sunliguo2020/48v-ev-monitor-board/程序运行顺序.md

Arduino（ESP8266/ESP32 Arduino框架）程序的执行顺序和普通 C 程序不一样，它不是从文件第一行开始执行，而是由框架调用。

你的 `wireless_meter.ino` 执行流程如下：

```
上电 / 复位
       │
       ▼
Arduino核心初始化
       │
       ▼
setup()
       │
       ▼
loop()
       │
       └────不断循环执行
```

---

## 1. 上电后首先执行 setup()

你的程序第一步进入：

```cpp
void setup()
{
  Serial.begin(115200);

  BLINKER_DEBUG.stream(Serial);
  BLINKER_DEBUG.debugAll();

  ...
}
```

也就是说：

### 第一步：

打开串口：

```cpp
Serial.begin(115200);
```

串口输出：

```
115200波特率
```

---

## 2. 读取 EEPROM 中的 WiFi 配置

接下来：

```cpp
if (!loadWiFiConfig())
{
  Serial.println("没有存储的 WiFi 配置，进入配网模式...");
  startConfigPortal();
}
```

执行：

```
loadWiFiConfig()
```

流程：

```
EEPROM.begin()
       |
       |
读取地址3000
       |
       |
判断是否等于0xA5
       |
       |
读取:
SSID
密码
Blinker Auth
```

如果没有配置：

进入：

```cpp
startConfigPortal();
```

启动AP：

```
EVMeter_Config
```

等待手机连接配网。

---

## 3. 连接 WiFi

如果 EEPROM 有数据：

执行：

```cpp
connectWiFi()
```

里面：

```cpp
WiFi.begin(ssid, pswd);
```

等待：

```
WiFi连接成功
```

例如：

```
Connected, IP:192.168.1.xxx
```

---

## 4. 初始化 Blinker

接下来：

```cpp
Blinker.begin(auth, ssid, pswd);
```

连接云端。

然后绑定各种回调：

### 心跳：

```cpp
Blinker.attachHeartbeat(heartbeat);
```

以后每隔一定时间执行：

```
heartbeat()
```

---

### 数据存储：

```cpp
Blinker.attachDataStorage(dataStorage);
```

执行：

```
dataStorage()
```

上传历史数据。

---

### 小爱控制：

```cpp
BlinkerMIOT.attachPowerState(miotPowerState);
```

语音控制进入：

```
miotPowerState()
```

---

## 5. GPIO初始化

继续：

```cpp
pinMode(D6, OUTPUT);
digitalWrite(D6, HIGH);
```

这里：

D6 是你的输出控制 MOS 管。

上电：

```
D6=高电平
```

打开输出。

蜂鸣器：

```cpp
pinMode(D5, OUTPUT);
digitalWrite(D5, LOW);
```

关闭蜂鸣器。

---

## 6. 绑定APP按键

执行：

```cpp
Button2.attach(button2_callback);
Button9.attach(button9_callback);
Button7.attach(button7_callback);
Button8.attach(button8_callback);
Button6.attach(button6_callback);
```

以后：

APP按键2：

```
button2_callback()
```

APP屏幕开关：

```
button9_callback()
```

APP清除：

```
button7_callback()
```

APP模式：

```
button8_callback()
```

APP重启：

```
button6_callback()
```

---

## 7. 初始化DHT11

这里：

```cpp
dht.begin();
```

启动：

```
温湿度传感器
```

---

## 8. 初始化NTP时间

```cpp
timeClient.begin();
```

启动：

```
阿里云时间服务器
```

---

## 9. 初始化 INA226

这里是你的关键：

```cpp
ina226Ready = initINA226();
```

进入：

```
initINA226()
```

里面：

### I2C启动：

```cpp
Wire.begin();
```

### 检查 INA226 地址：

```cpp
Wire.beginTransmission(0x44);
```

你的INA226地址：

```
0x44
```

读取配置寄存器：

```
CONFIG
```

然后：

```cpp
ina.begin(0x44);
```

配置：

```cpp
ina.configure(
INA226_AVERAGES_128,
INA226_BUS_CONV_TIME_1100US,
INA226_SHUNT_CONV_TIME_1100US,
INA226_MODE_SHUNT_BUS_CONT
);
```

也就是：

```
平均128次
母线转换1.1ms
分流转换1.1ms
电压+电流连续模式
```

校准：

```cpp
ina.calibrate(0.002,40);
```

表示：

```
分流电阻 0.002Ω
最大电流40A
```

---

## 10. 初始化OLED

执行：

```cpp
u8g2.begin();
```

启动：

```
SSD1306 OLED
```

然后：

```cpp
displaygif();
```

显示动画。

再：

```cpp
connectHell();
```

显示：

```
尊贵的车主！
Hell!
戴头盔注意安全！
```

setup结束。

---

# 11. 进入 loop()

setup执行一次后：

进入：

```cpp
void loop()
{
```

然后无限循环。

你的loop主要流程：

```
loop()
 |
 |
 +-- Blinker.run()
 |
 +-- 更新时间
 |
 +-- Runtime()
 |
 +-- 每200ms采集一次
 |       |
 |       +-- INA226读取
 |       |
 |       +-- 电压
 |       +-- 电流
 |       +-- 功率
 |       +-- 电量
 |       +-- 里程
 |
 +-- DHT11读取
 |
 +-- 自动模式保护
 |
 +-- 手动模式控制
 |
 +-- 超压保护
 |
 +-- 过温保护
 |
 +-- 过流保护
 |
 +-- OLED显示
```

---

# 你的实际运行主线图

```
上电
 |
 ▼
setup()
 |
 +-- EEPROM读取WiFi
 |
 +-- WiFi连接
 |
 +-- Blinker连接
 |
 +-- GPIO初始化
 |
 +-- DHT11初始化
 |
 +-- NTP初始化
 |
 +-- INA226初始化
 |
 +-- OLED初始化
 |
 +-- GIF
 |
 +-- 欢迎画面
 |
 ▼
loop()
 |
 +-- 采集电压
 |
 +-- 采集电流
 |
 +-- 计算电量
 |
 +-- 判断保护
 |
 +-- 控制D6 MOS输出
 |
 +-- 更新OLED
 |
 +-- 上传APP
 |
 └────重复
```

---

针对你这个 **48V新能源电动车监测板**，真正核心运行位置是：

1. **采集数据**

```cpp
BusVoltage = ina.readBusVoltage()*Vscale;
ShuntCurrent = ina.readShuntCurrent();
```

2. **保护判断**

```cpp
if(BusVoltage < 42.9)
```

```cpp
if(temp_read >55)
```

```cpp
if(ShuntCurrent < -25)
```

3. **控制输出**

```cpp
digitalWrite(D6,HIGH/LOW);
```

4. **显示**

```cpp
displayALL();
```

这四部分构成你的主程序。你这个程序结构已经比较完整，接近一个成品电动车BMS辅助监测系统。
