sunliguo2020/48v-ev-monitor-board/images/PCB_PCB1_2026-07-01.png

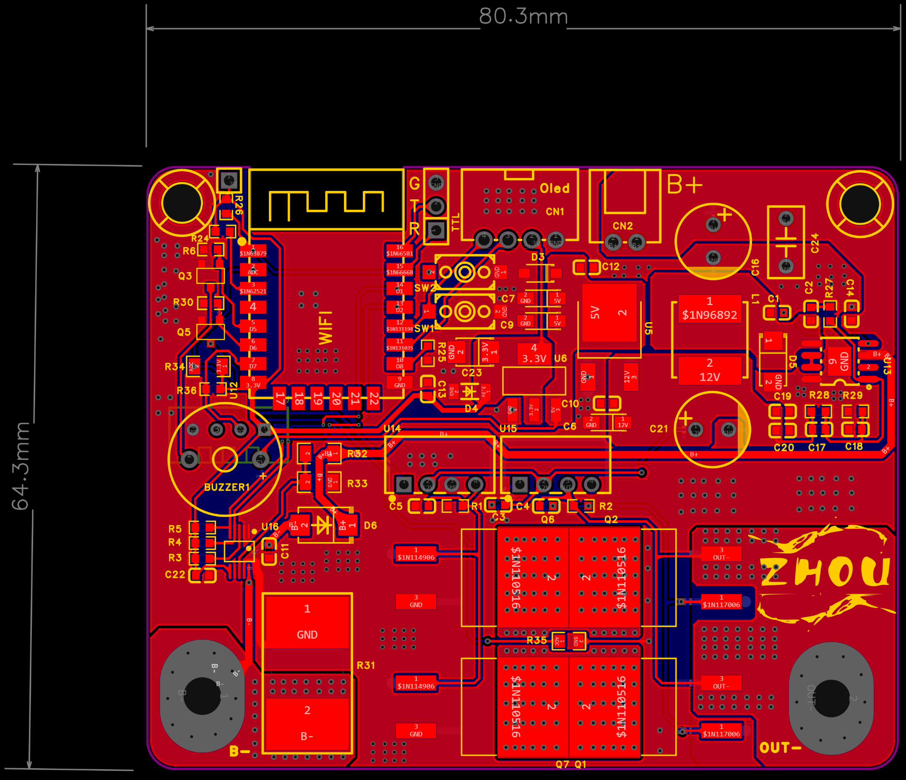
images/PCB_PCB1_2026-07-01.png
