sunliguo2020/48v-ev-monitor-board/CHANGELOG.md

# CHANGELOG

## [2026-07-16]

### 重构
- WiFi 配网功能单独抽离为独立模块 (`WiFi_Config.cpp/.h`)

## [2026-07-13]

### 重构
- 将开机显示 GIF 图片的部分分离出来 (`DisplayGif.cpp/.h`, `Gif.cpp/.h`)

## [2026-07-10]

### 文档
- 添加程序运行逻辑说明文档 (`程序运行顺序.md`)
- 部分函数增加注释

## [2026-07-08]

### 修复
- 修复 INA226 不能正确读取电压的问题
- 寻找 INA226 正确的 I2C 地址

## [2026-07-07]

### 新功能
- 配网界面适配手机浏览器
- 增加 `.gitignore` 文件
- 旋转图片显示

### 修复
- 修复 WiFi 配置持久化问题：移动 EEPROM 区域以避免与 Blinker 重叠；增加安全的 EEPROM 读写和调试日志

## [2026-07-01]

### 文档
- 更新 README 文件
- 添加网表文件以及原理图 (PCB 文档)

### 其他
- 删除重复的文件

## [2026-06-21]

### 文档
- 更新 `wireless_meter.ino` 开头注释
- 更新 README.md：基于 `wireless_meter.ino` 功能添加详细项目文档

### 代码优化
- 格式化代码：改进 `wireless_meter.ino` 的代码风格和一致性

## [2023-04-16]

### 修复
- 修改导致编译失败的程序错误

### 其他
- 使用 INA226 库

## [2023-04-11]

### 修复
- 修复低压报警，手动打开蜂鸣无法关断问题
- 修复低压报警手动打开、报警页面卡滞问题

### 已知问题
- 电池彻底亏电，控制板无法启动导致无法充电问题。需要复刻的朋友需要自己设计增加二极管将 GND 与 OUT- 隔离后与 DCDC 连接，即使电池彻底亏电，充电器也可以启动系统。
