sunliguo2020/48v-ev-monitor-board/pcb/SCH_Schematic1_2026-06-07.pdf

# GNDB-

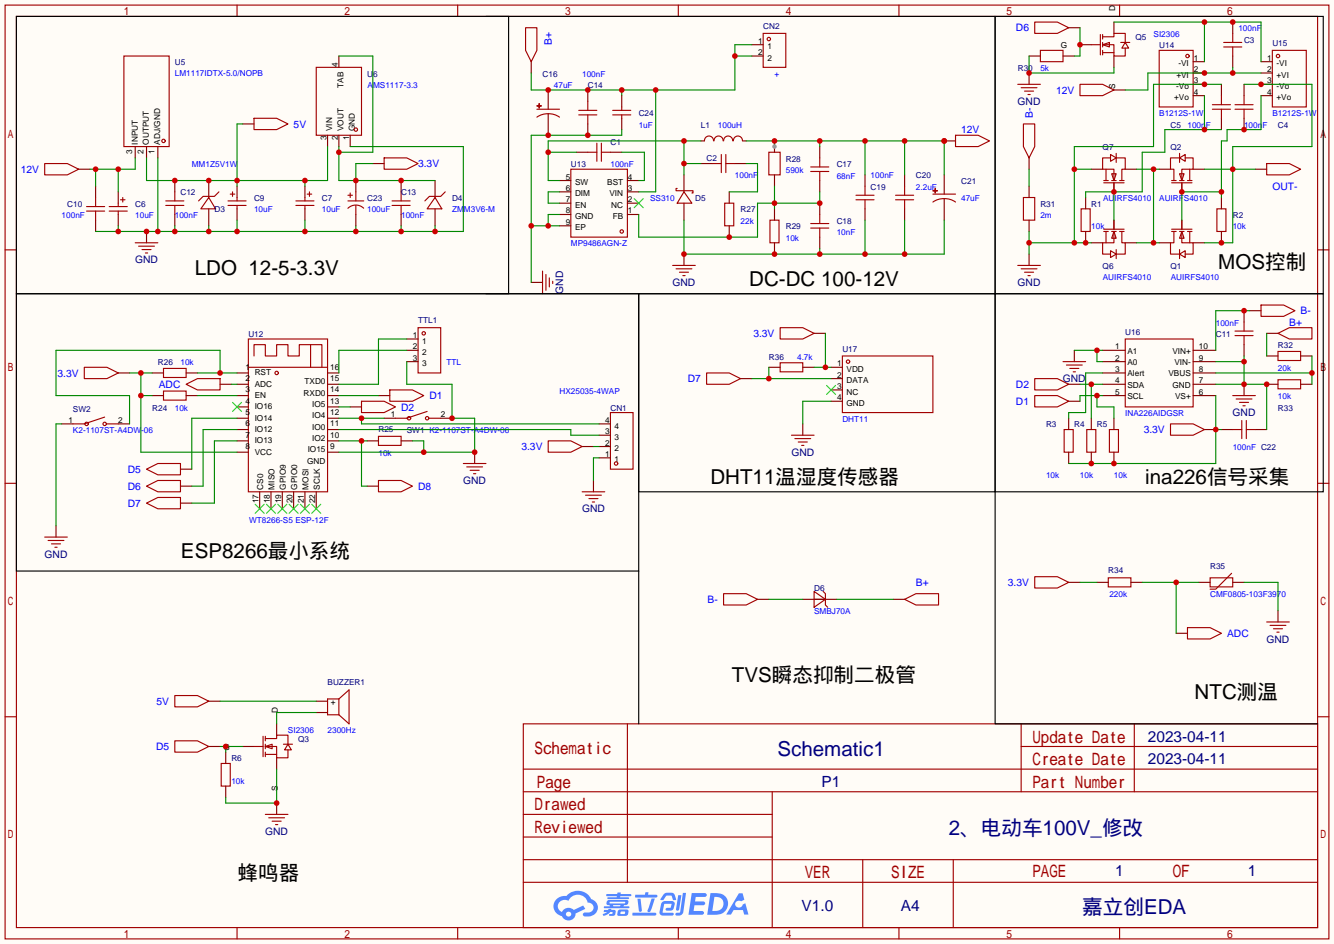
[picture p3: page 1]
