sunliguo2020/48v-ev-monitor-board/pcb/SCH_Schematic1_2026-06-21.pdf

# GNDB-

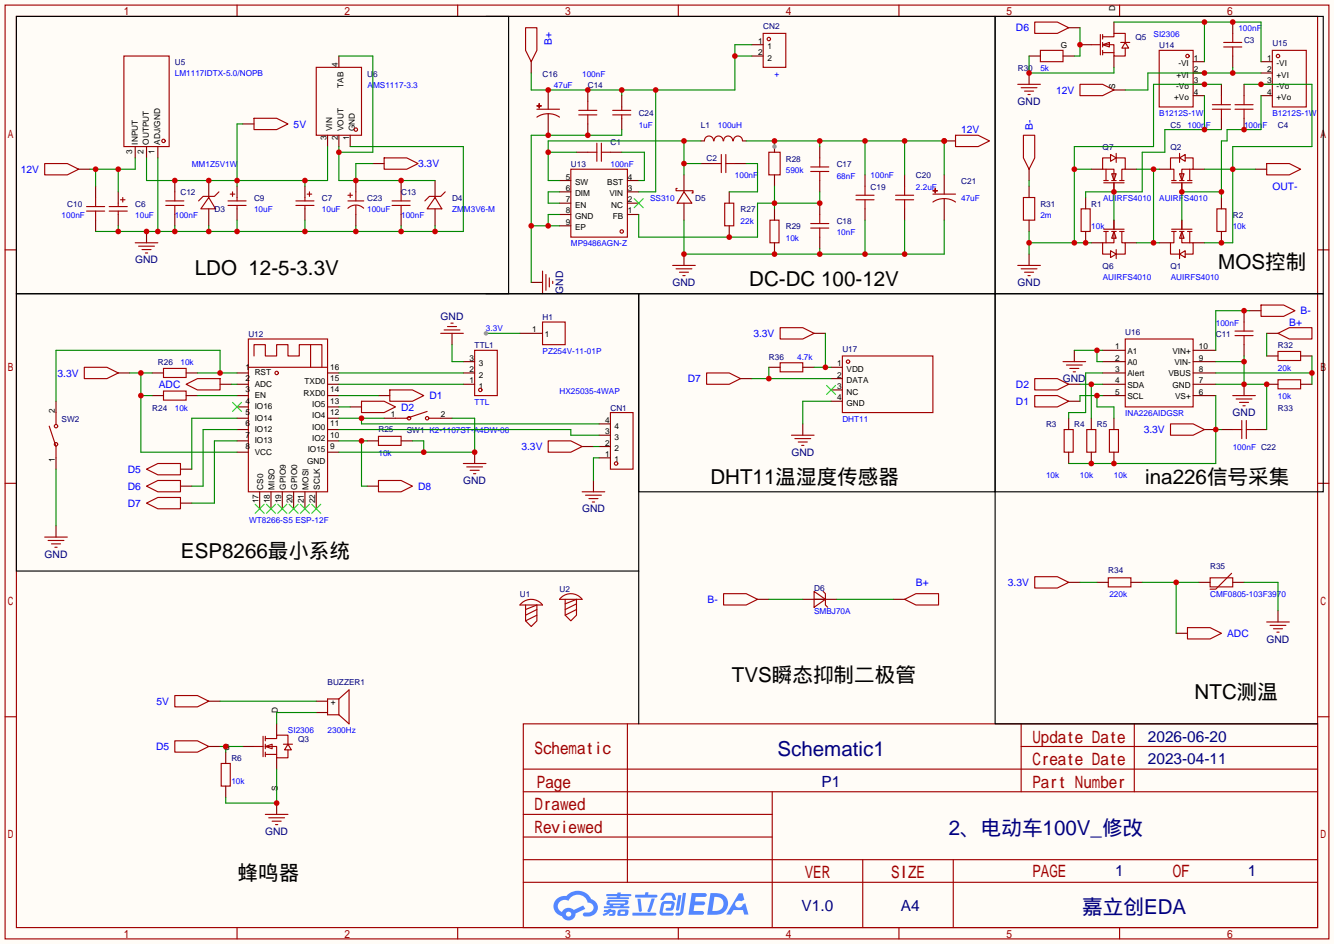
[picture p4: page 1]
