sunliguo2020/48v-ev-monitor-board/wireless_meter/Gif.cpp

#include <Arduino.h>
#include "Gif.h"
const int gif_length = GIF_LENGTH;


const uint8_t gif[GIF_LENGTH][512] PROGMEM ={
0x00, 0x00, 0x00, 0x00, 0x00, 0x00, 0x00, 0x00, 0x00, 0x00, 0x00, 0x00, 0x00, 0x00, 0x00, 0x00, 
0x00, 0x00, 0x00, 0x00, 0x00, 0x00, 0x00, 0x00, 0x00, 0x00, 0x00, 0x00, 0x98, 0x00, 0x00, 0x00, 
0x00, 0x00, 0x00, 0x00, 0x0c, 0x01, 0x00, 0x00, 0x00, 0x00, 0x00, 0x00, 0x61, 0x02, 0x00, 0x00, 
0x00, 0x00, 0x00, 0x80, 0x70, 0x04, 0x00, 0x00, 0x00, 0x00, 0x00, 0xc0, 0x10, 0x08, 0x00, 0x00, 
0x00, 0x00, 0x00, 0x00, 0x70, 0x10, 0x00, 0x00, 0x00, 0x00, 0x00, 0x1e, 0xf0, 0x01, 0x00, 0x00, 
0x00, 0x00, 0xe0, 0x3f, 0x30, 0x33, 0x7c, 0x00, 0x00, 0x00, 0xfc, 0x3f, 0x7a, 0xf2, 0xff, 0x00, 
0x00, 0x00, 0xff, 0xbf, 0x6c, 0xf3, 0xff, 0x00, 0x00, 0xc0, 0xff, 0xbf, 0x98, 0xf3, 0xff, 0x1f, 
0x00, 0xf0, 0xff, 0x3f, 0xd0, 0xf1, 0x9f, 0x1f, 0x00, 0xf8, 0xff, 0x3f, 0xf0, 0xf0, 0x1f, 0x3f, 
0x00, 0xfc, 0xff, 0x7f, 0x60, 0xf8, 0x1f, 0x39, 0x00, 0xfe, 0xff, 0x7f, 0x60, 0xf8, 0x1f, 0x38, 
0x00, 0xfe, 0xff, 0x7f, 0x21, 0xf8, 0x0f, 0x38, 0x00, 0xfe, 0xff, 0xff, 0xff, 0xff, 0x07, 0x1e, 
0x00, 0xfc, 0xff, 0xff, 0xff, 0xff, 0x07, 0x0c, 0x00, 0xfc, 0xff, 0xff, 0xff, 0xff, 0x7f, 0x1c, 
0x00, 0xf8, 0xff, 0xff, 0xff, 0xff, 0x7f, 0x1c, 0x00, 0xf8, 0xff, 0xff, 0xff, 0xff, 0xff, 0x3e, 
0x00, 0xf8, 0xff, 0xff, 0xff, 0xff, 0xff, 0x3f, 0x00, 0xf8, 0xff, 0xff, 0xff, 0xff, 0xff, 0x3f, 
0x00, 0xfc, 0xff, 0xff, 0xff, 0xff, 0xff, 0x1f, 0x00, 0xfe, 0xff, 0xff, 0xff, 0xff, 0xff, 0x0f, 
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
0x00, 0x00, 0xe0, 0xbf, 0x30, 0x63, 0x7c, 0x00, 0x00, 0x00, 0xfc, 0xbf, 0x7e, 0xf2, 0xff, 0x00, 
0x00, 0x00, 0xff, 0x3f, 0x4c, 0xf7, 0xff, 0x01, 0x00, 0xc0, 0xff, 0x3f, 0x98, 0xf3, 0xff, 0x1f, 
0x00, 0xf0, 0xff, 0x3f, 0xf0, 0xf1, 0x1f, 0x3f, 0x00, 0xf8, 0xff, 0x7f, 0xe0, 0xf0, 0x1f, 0x3b, 
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
};
