sunliguo2020/48v-ev-monitor-board/(commit log)

2023-03-31 删除文件 6.电动车电池监测 -第四次调试 -增加电量图标 -调整历史表格 - 调整屏幕温度显示 -.rar
2023-03-31 删除文件 wireless_meter.ino
2023-03-31 删除文件 Gif.h
2023-03-31 该图形库来源于网络
2023-04-11 修复低压报警，手动打开蜂鸣无法关断问题，修复低压报警手动打开、报警页面卡滞问题
2023-04-16 使用此INA226库
2023-04-16 修改导致编译失败的程序错误
2026-06-20 Format code: improve code style and consistency in wireless_meter.ino
2026-06-20 PCB文档
2026-06-20 Update README.md: Add detailed project documentation based on wireless_meter.ino functionality
2026-06-21 更新 wireless_meter.ino 开头注释
2026-07-01 删除重复的文件
2026-07-01 网表文件以及原理图
2026-07-01 更新readme文件。
2026-07-07 旋转图片
2026-07-07 fix: persist WiFi config — move EEPROM region to avoid Blinker overlap; add safe EEPROM read/write and debug logs
    [wireless_meter.ino]
2026-07-07 似乎是开机动画
2026-07-07 增加.gitignore文件
2026-07-07 配网界面适配手机浏览器
2026-07-08 寻找ina226正确的i2c地址
2026-07-08 fix: 修复INA226不能正确读取电压的问题
2026-07-09 部分函数增加注释
2026-07-09 程序的运行逻辑
2026-07-13 将开机显示gif图片的部分分离出来。
2026-07-16 wifi配网单独抽离
2026-07-16 更新changelog.md文件
